Ivan-Casas/GARRA-OS-Reporte-Final-Repositorio-y-Video/Documentación Técnica/fotos_prototipo/prototipo_1.jpeg

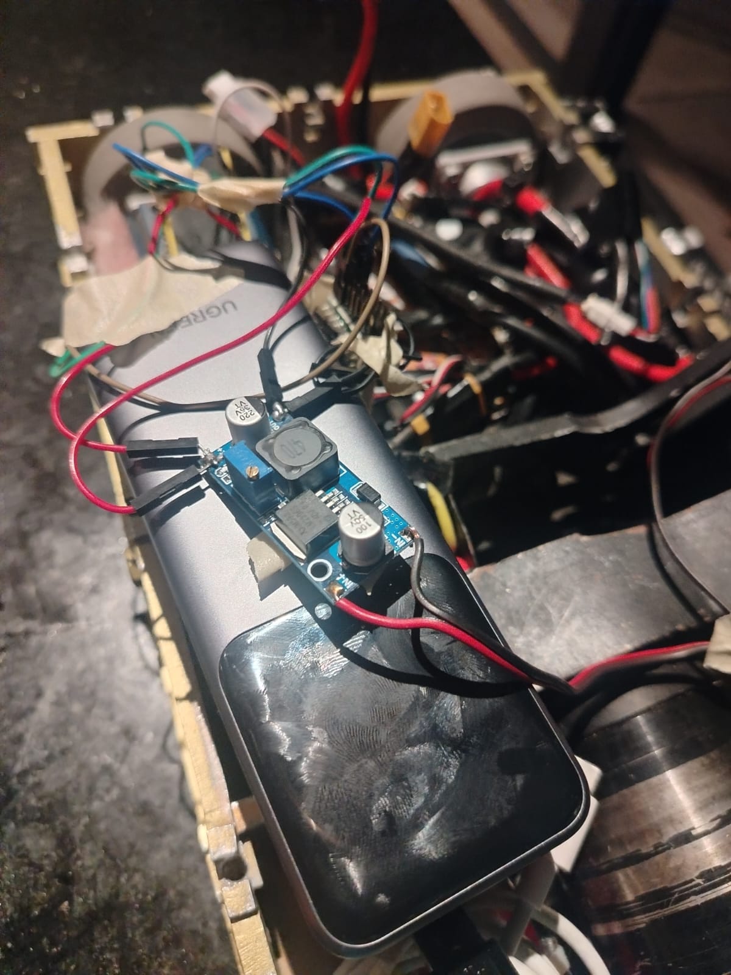
Documentación Técnica/fotos_prototipo/prototipo_1.jpeg
