Ivan-Casas/GARRA-OS-Reporte-Final-Repositorio-y-Video/Documentación Técnica/capturas_supabase/control_comandos.jpeg

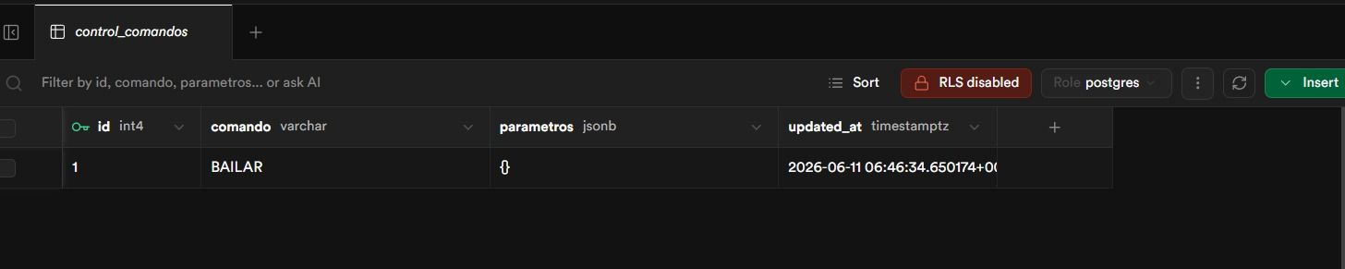
Documentación Técnica/capturas_supabase/control_comandos.jpeg
