Ivan-Casas/GARRA-OS-Reporte-Final-Repositorio-y-Video/Documentación Técnica/fotos_prototipo/prototipo_2.jpeg

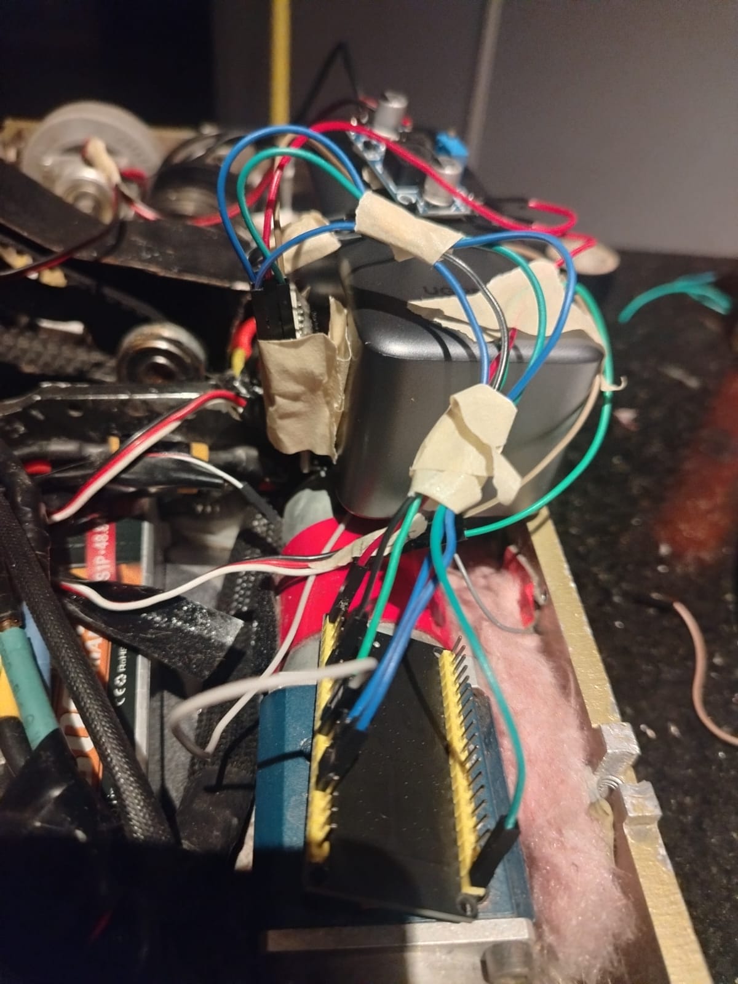
Documentación Técnica/fotos_prototipo/prototipo_2.jpeg
