Ivan-Casas/GARRA-OS-Reporte-Final-Repositorio-y-Video/Documentación Técnica/fotos_prototipo/prototipo_4.jpeg

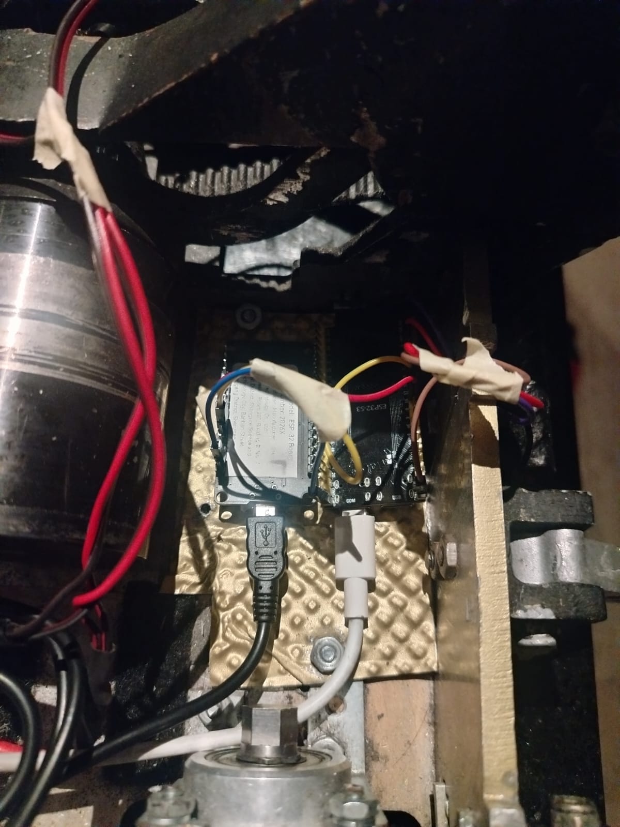
Documentación Técnica/fotos_prototipo/prototipo_4.jpeg
