Ivan-Casas/GARRA-OS-Reporte-Final-Repositorio-y-Video/Documentación Técnica/fotos_prototipo/prototipo_7.jpeg

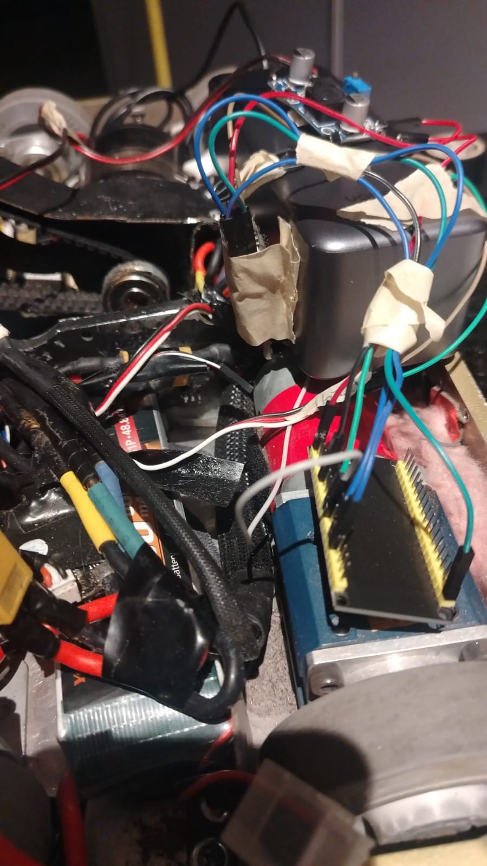
Documentación Técnica/fotos_prototipo/prototipo_7.jpeg
